ah01/rpi-i2c-mini-hat/doc/photo/01.jpg

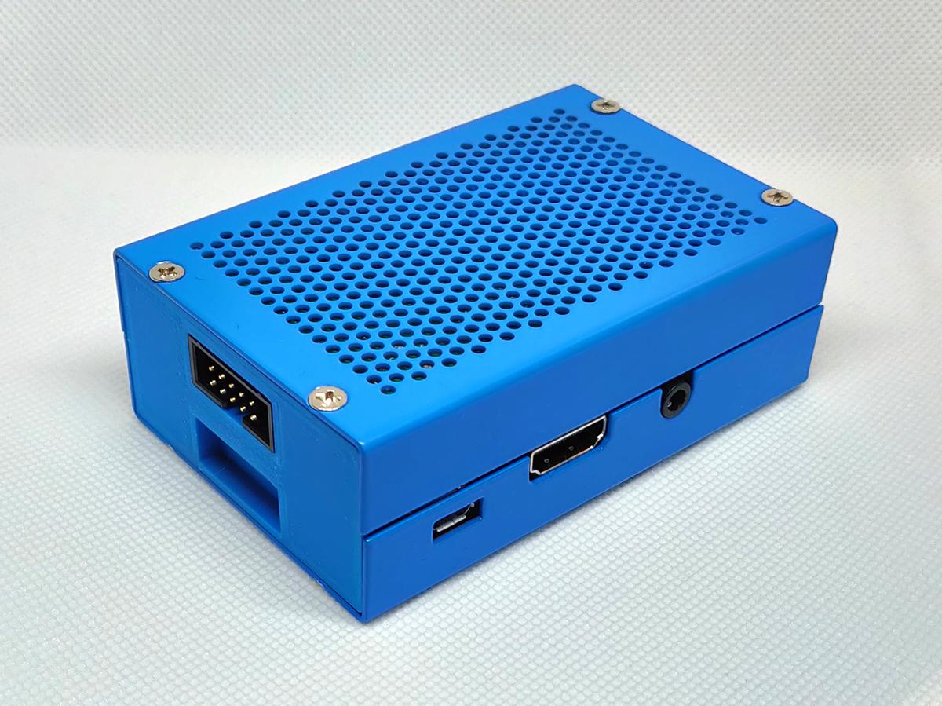
doc/photo/01.jpg
