ah01/rpi-i2c-mini-hat/doc/photo/06.jpg

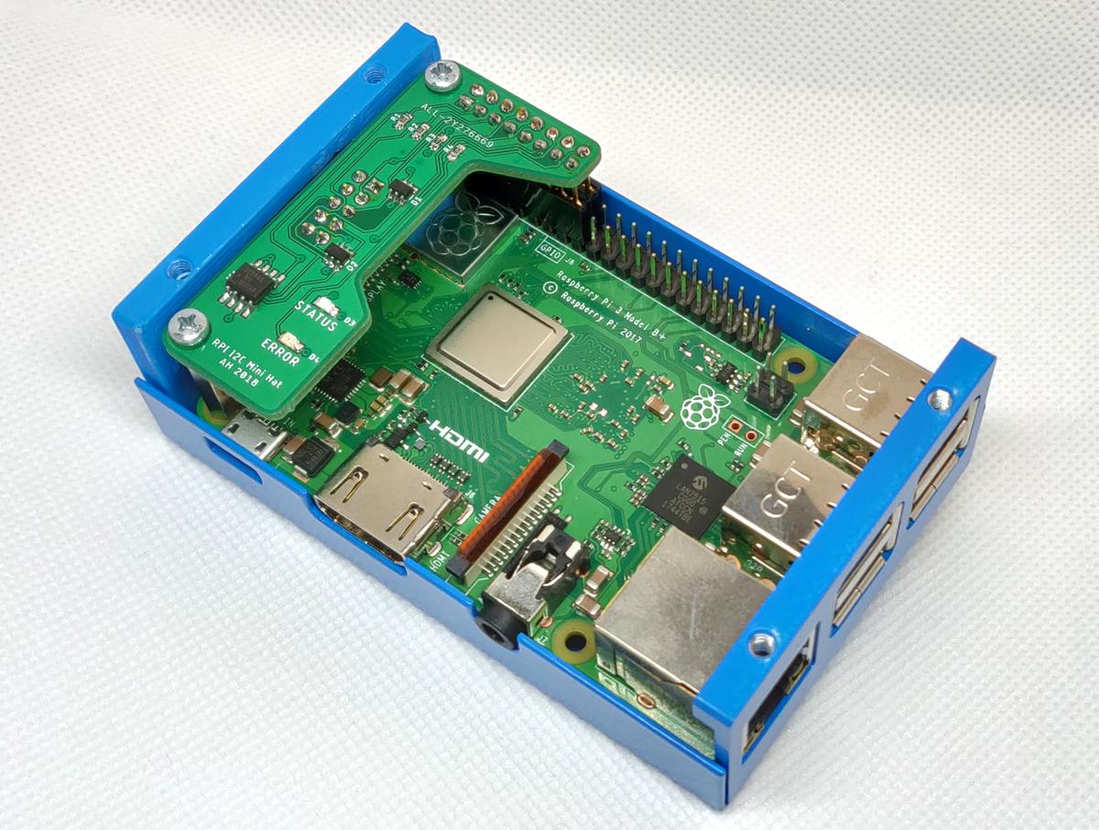
doc/photo/06.jpg
