ah01/rpi-i2c-mini-hat/doc/rpi-i2c-pcb-bottom.png

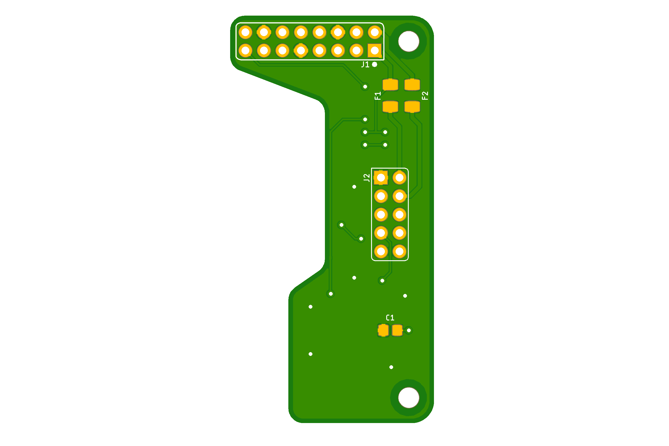
doc/rpi-i2c-pcb-bottom.png
