ah01/rpi-i2c-mini-hat/doc/rpi-i2c-pcb-top-photo.jpg

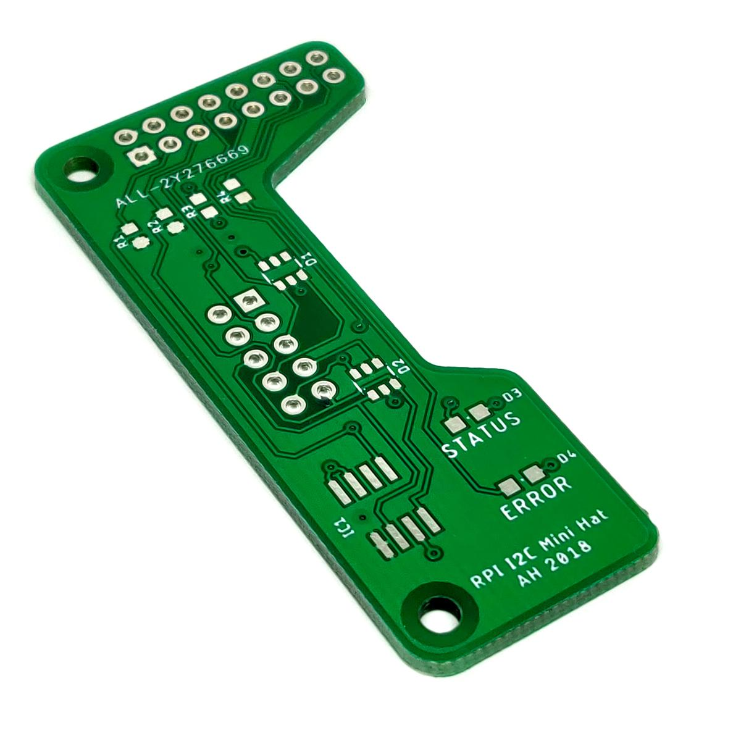
doc/rpi-i2c-pcb-top-photo.jpg
