ah01/rpi-i2c-mini-hat/doc/rpi-i2c-pcb-top.png

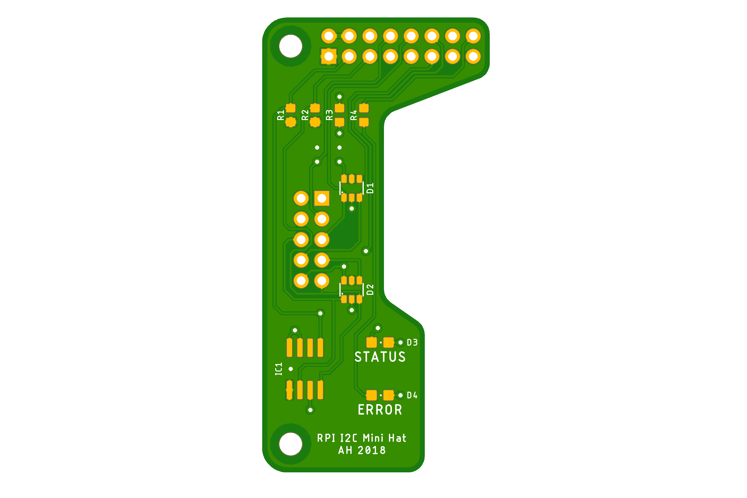
doc/rpi-i2c-pcb-top.png
