ah01/rpi-i2c-mini-hat/panel/panel.stl

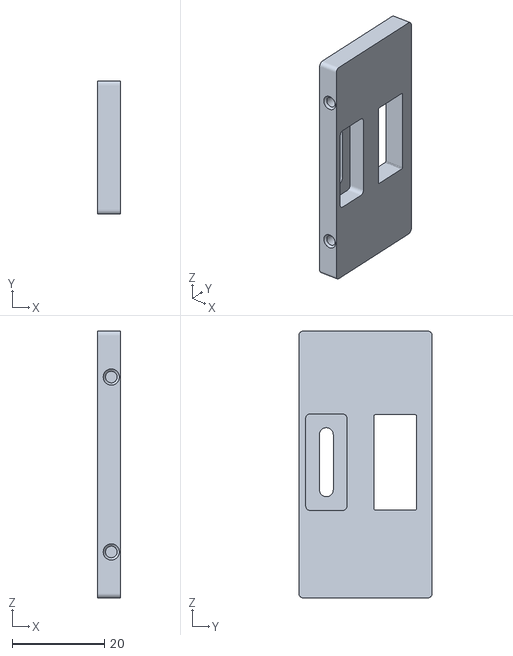
[picture p23: CAD file, 2019-02-13]
panel/panel.stl
5.00 x 29.0 x 58.0
