ah01/rpi-i2c-mini-hat/doc/rpi-i2c-sch.pdf

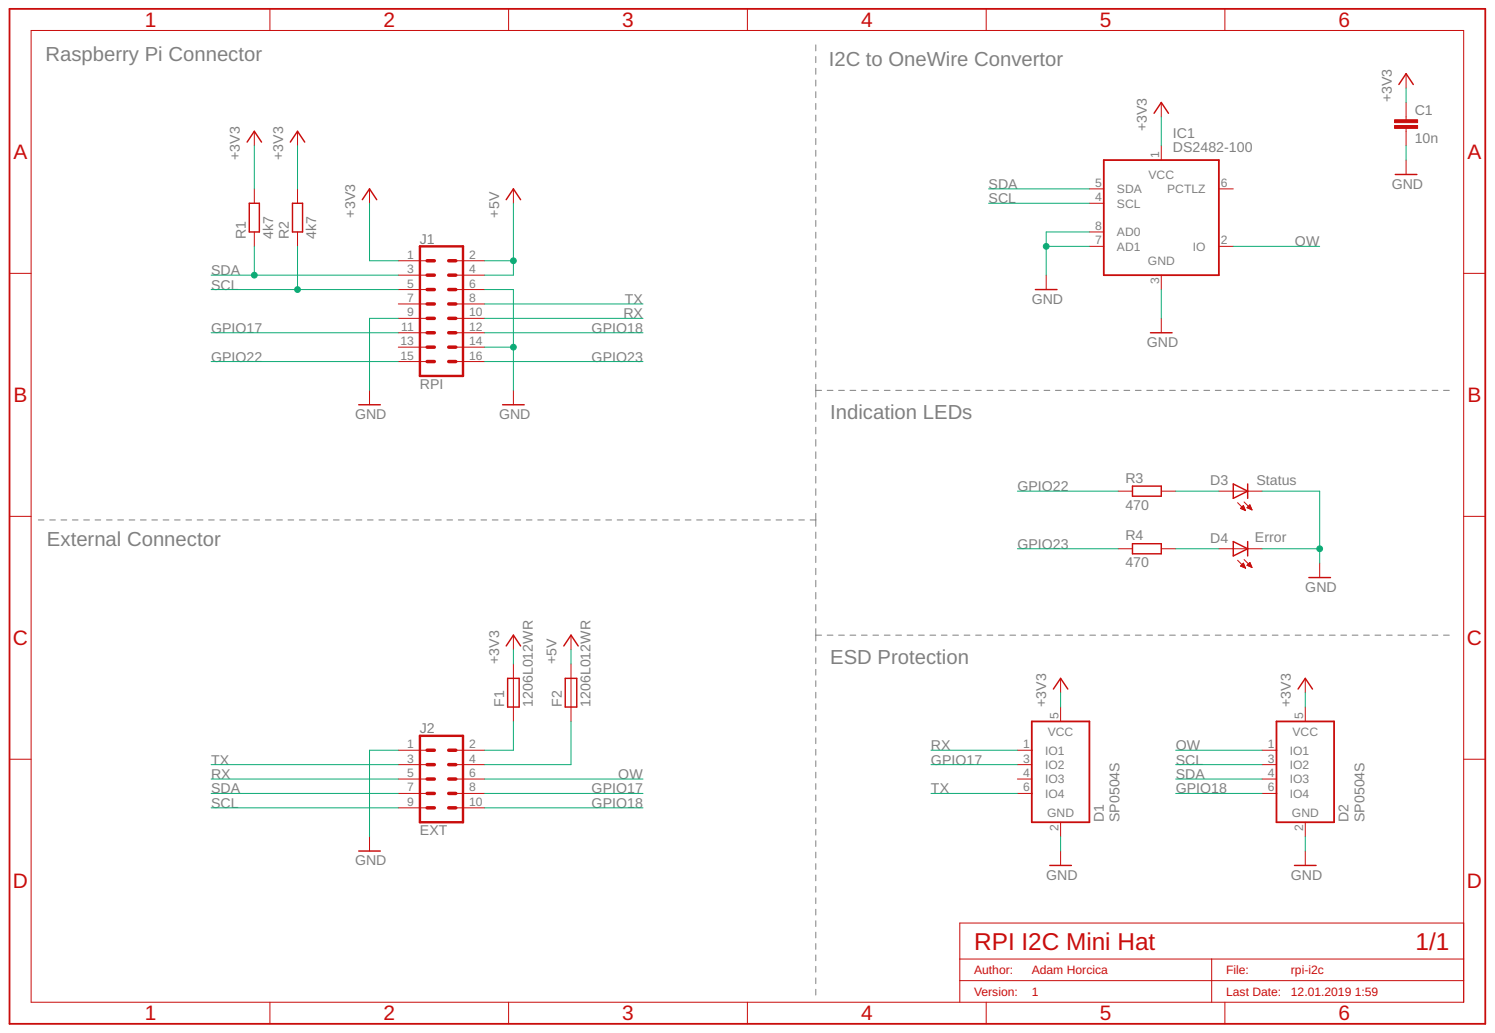
[picture p24: page 1]

1 RPI I2C Mini Hat Adam Horcica
