ah01/rpi-i2c-mini-hat/pcb/rpi-i2c.brd

## EAGLE design pcb/rpi-i2c.brd (2019-01-12)

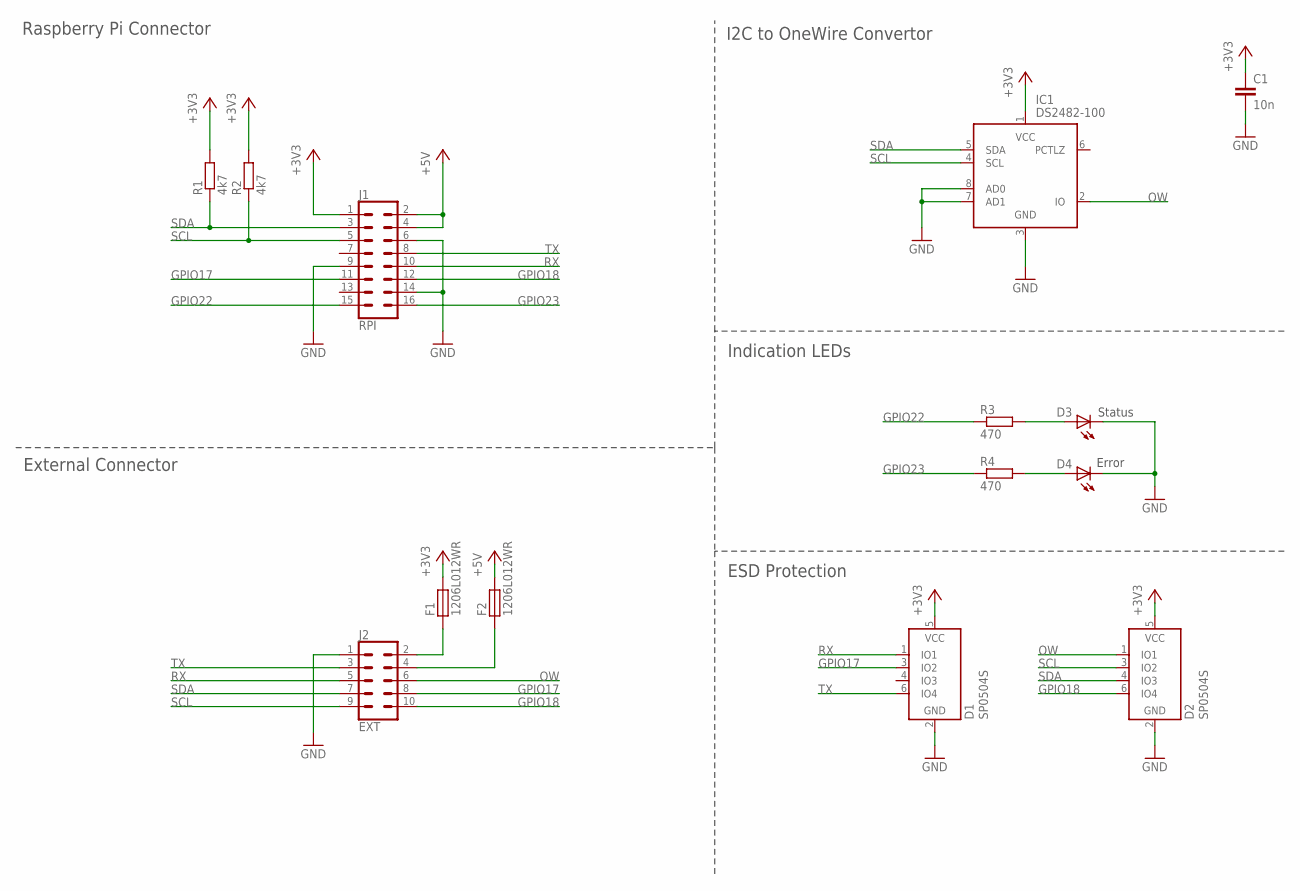
[picture p25: schematic rpi-i2c.sch]

Parts:
C1: 10n; C0805
D1, D2: SP0504S; SOT23-6
D3, D4: LEDCHIPLED_0805; CHIPLED_0805
F1, F2: 1206L012WR; C1206K
IC1: DS2482-100; SO08
J1: RPI; 2X8-INVERSE
J2: EXT; 30310-5002HB
R1, R2: 4k7; R0603
R3, R4: 470; R0603

Connections:
3V3F: F1.1, J2.2
5V0F: F2.1, J2.4
+3V3: C1.1, D1.5 (VCC), D2.5 (VCC), F1.2, IC1.1 (VCC), J1.1, R1.2, R2.2
+5V: F2.2, J1.2, J1.4
GND: C1.2, D1.2 (GND), D2.2 (GND), D3.C, D4.C, IC1.3 (GND), IC1.7 (AD1), IC1.8 (AD0), J1.6, J1.9, J1.14, J2.1
GPIO17: D1.3 (IO2), J1.11, J2.8
GPIO18: D2.6 (IO4), J1.12, J2.10
GPIO22: J1.15, R3.2
GPIO23: J1.16, R4.2
unnamed: D3.A, R3.1
unnamed: D4.A, R4.1
OW: D2.1 (IO1), IC1.2 (IO), J2.6
RX: D1.1 (IO1), J1.10, J2.5
SCL: D2.3 (IO2), IC1.4 (SCL), J1.5, J2.9, R2.1
SDA: D2.4 (IO3), IC1.5 (SDA), J1.3, J2.7, R1.1
TX: D1.6 (IO4), J1.8, J2.3

Notes on the sheet:
Raspberry Pi Connector
External Connector
I2C to OneWire Convertor
Indication LEDs
ESD Protection
Status
Error

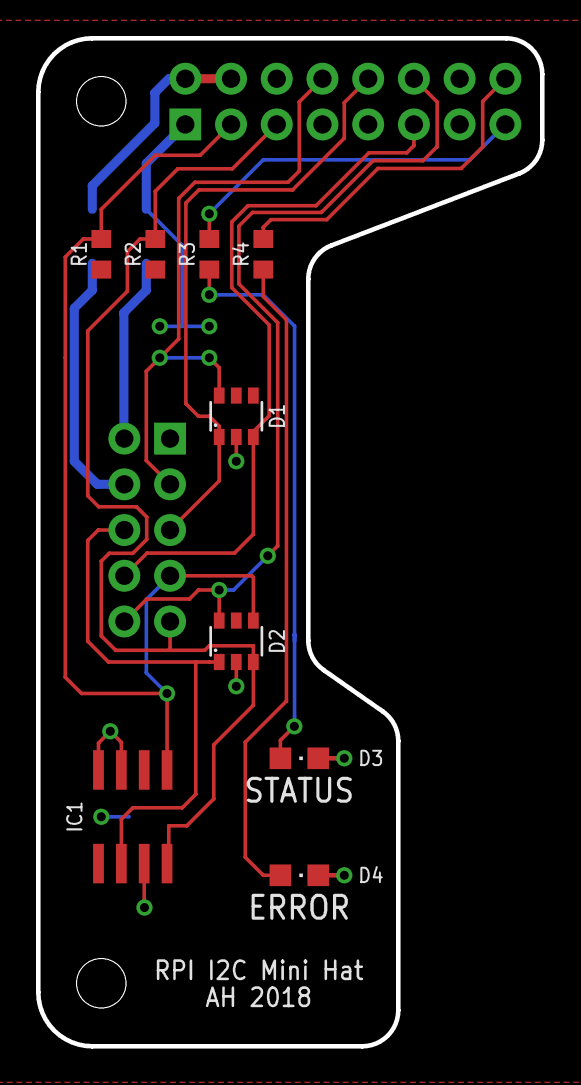
[picture p26: board rpi-i2c.brd from above]

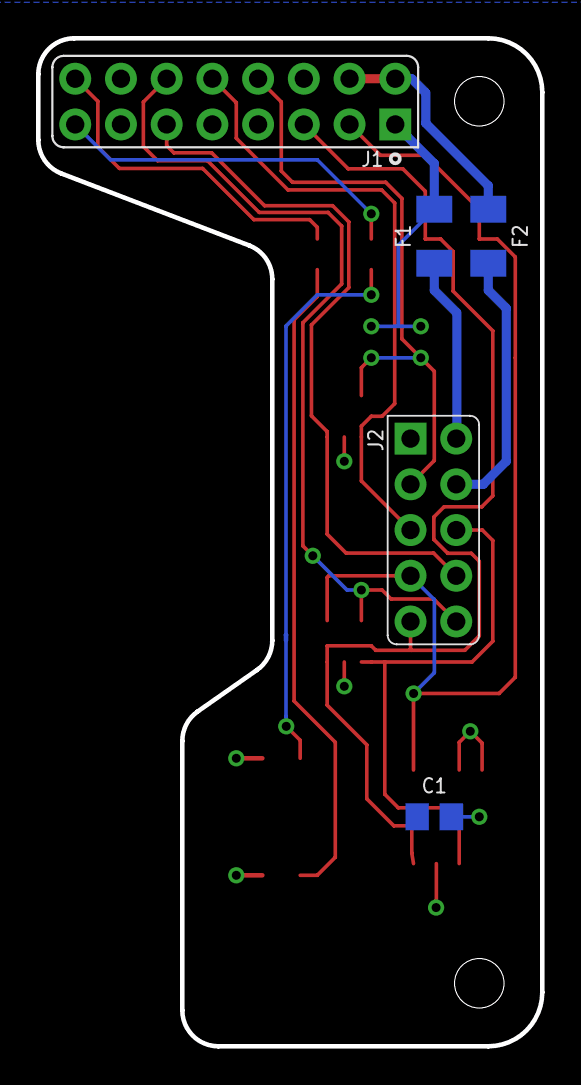
[picture p27: board rpi-i2c.brd from below]

Board: 2 copper layers, 28.0 x 56.0 mm, 14 parts (5 on the bottom side), 16 nets.
