ah01/rpi-i2c-mini-hat/(commit log)

2019-01-12 Add original PCB (version used for order PCB)
    [rpi-i2c.brd, rpi-i2c.sch]
2019-01-12 Clean up schematics and save PCB image.
    [rpi-i2c.brd, rpi-i2c.sch]
2019-01-12 Add BOM
    [rpi-i2c-bom.csv]
2019-02-13 Panel STL file
    [panel.stl]
